AlejandroAriza12/uPMU.AlejandroAriza.LauraSofiaRico/README.md

# uPMU.AlejandroAriza.LauraSofiaRico
Prototipo de micro-sincrofasor (µPMU) de bajo costo para redes de distribución"
