AlejandroAriza12/uPMU.AlejandroAriza.LauraSofiaRico/circuito.jpeg

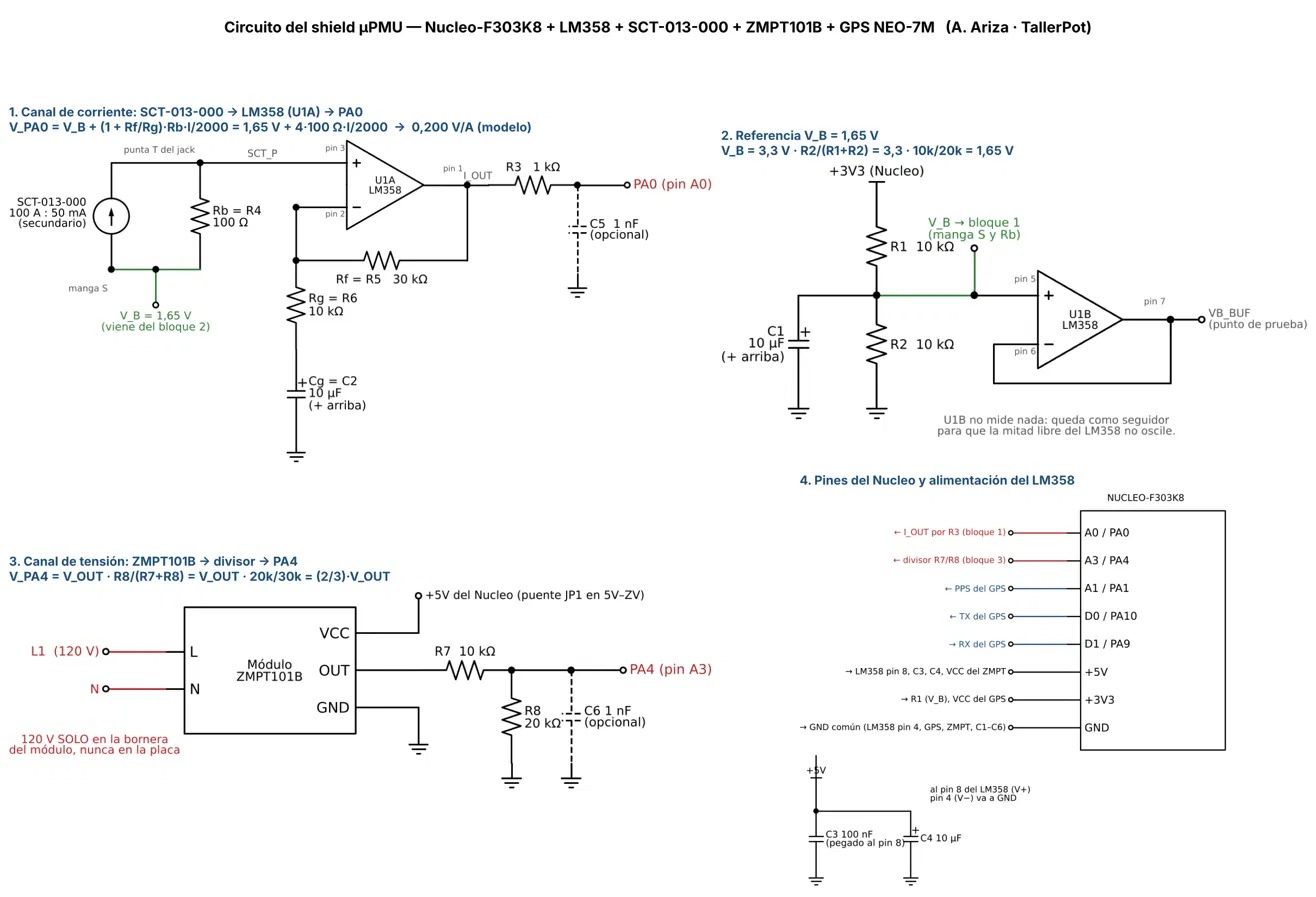
circuito.jpeg
