AlejandroAriza12/uPMU.AlejandroAriza.LauraSofiaRico/Datos_Fasores/real_armonicos.png

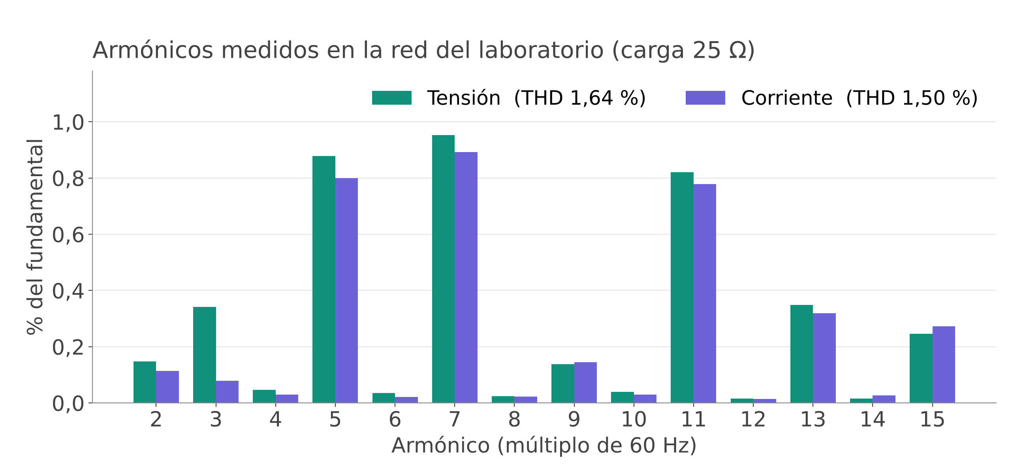
Datos_Fasores/real_armonicos.png
