AlejandroAriza12/uPMU.AlejandroAriza.LauraSofiaRico/Datos_Fasores/real_fasores_tiempo_real.png

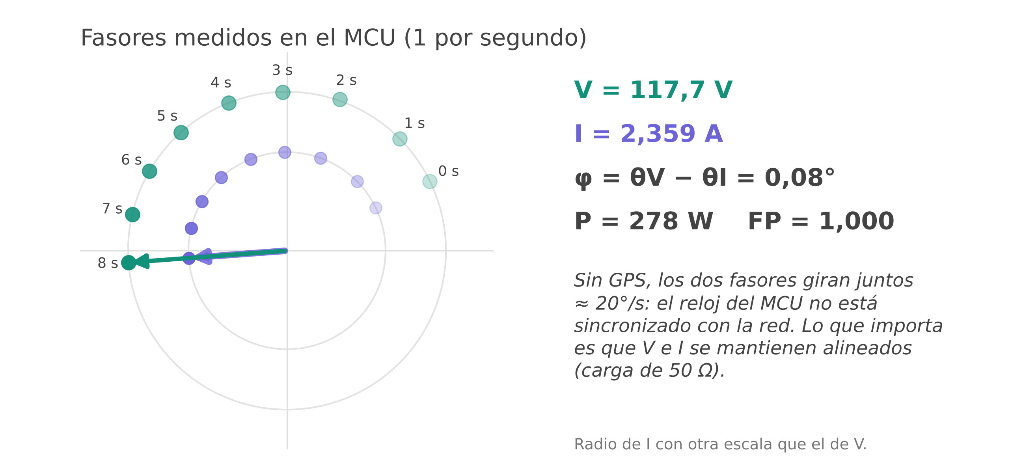
Datos_Fasores/real_fasores_tiempo_real.png
