AlejandroAriza12/uPMU.AlejandroAriza.LauraSofiaRico/Datos_Fasores/real_ondas_fasores.png

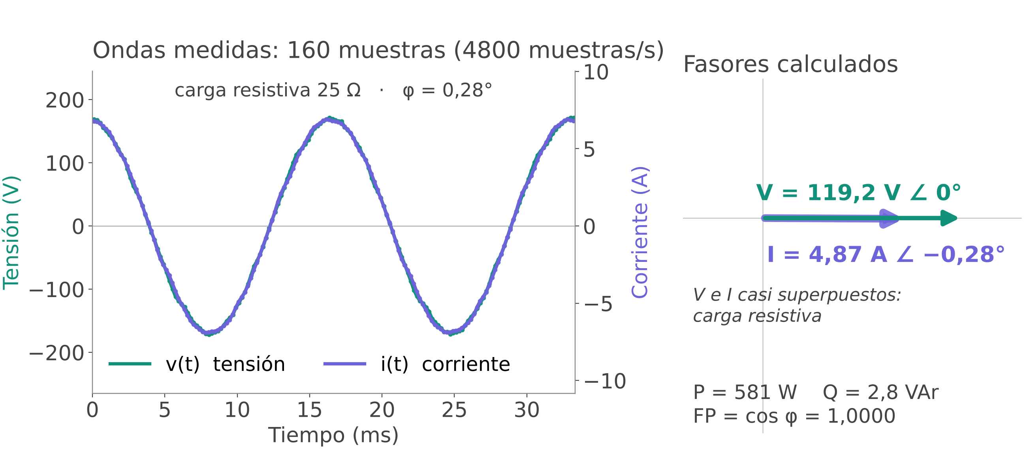
Datos_Fasores/real_ondas_fasores.png
