AlejandroAriza12/uPMU.AlejandroAriza.LauraSofiaRico/PCB/upmu_shield-imagen_placa.png

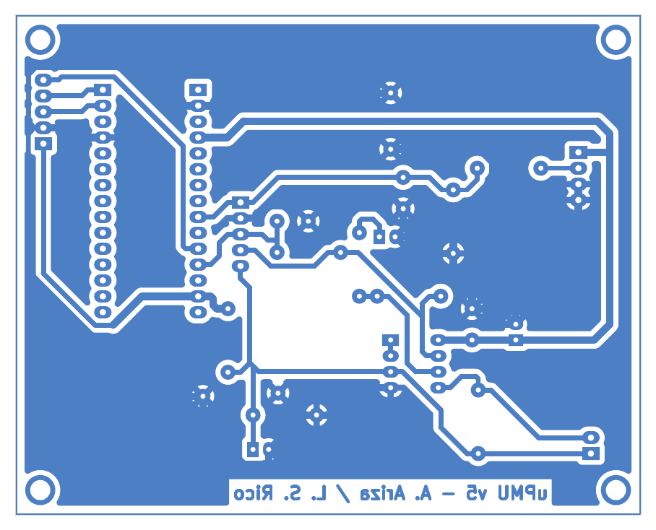
PCB/upmu_shield-imagen_placa.png
