AlejandroAriza12/uPMU.AlejandroAriza.LauraSofiaRico/Resultados_Error/bloques_analizados.csv

archivo | prueba | rol | modo | bloque | pps | seg | t_pc | fs_real | fs_origen | ppm | ref_V | ref_I | ref_ang | ref_f | mediaV | mediaI | satV | satI | Vpin | Ipin | angV | angI | f | f_ok | Vpin_aj | Ipin_aj | angV_aj | angI_aj | f_aj | resV_mV | resI_mV | thdV | thdI | lsb | V | I | angV_c | angI_c | angVI | P | Q | FP
2026-11-10_170417_r50_f.csv | r50 | calibracion | f | 0 | 0 | 0.0 | 1794348242.507 | 4800.0 | nominal (sin corregir) |  | 119.9 | 2.4 | 0.0 |  | 1956.409375 | 1894.69921875 | False | False | 0.27547204760598154 | 0.0001654240617624935 | -70.11402567466448 | -23.126642217747836 | 60.0343424392964 | True | 0.2755224057244155 | 0.00016549433904650433 | -70.09332687527079 | -23.10915620851965 | 60.03365634957356 | 5.127476702074537 | 1.1549581418792467 | 1.7539884433201036 |  | 0.0008058608058608059 | 119.93789970579621 | 0.000852417385092883 | -94.1955898330995 | -24.26664221774783 | -69.92894761535167 | 0.035086276141673756 | -0.09602805964166893 | 0.34318519103028344
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
