AlejandroAriza12/uPMU.AlejandroAriza.LauraSofiaRico/Resultados_Error/calibracion.csv

n_bloques | K_V | K_V_sd | n_V | K_I | K_I_sd | n_I | desfase_VI | desfase_VI_sd | n_ang | CAL_ANG_I | CAL_ANG_V | fase_origen
20 | 0.002296788990650208 | 2.1030589373012268e-06 | 20 | 0.1940646268546813 | 0.00026207088990200944 | 18 | 22.941564158435032 | 0.0707507361261869 | 18 | 1.14 | 24.081564158435032 | supuesta (red Rg-Cg)
