AlejandroAriza12/uPMU.AlejandroAriza.LauraSofiaRico/Resultados_Error/01_forma_de_onda_y_fasores.png

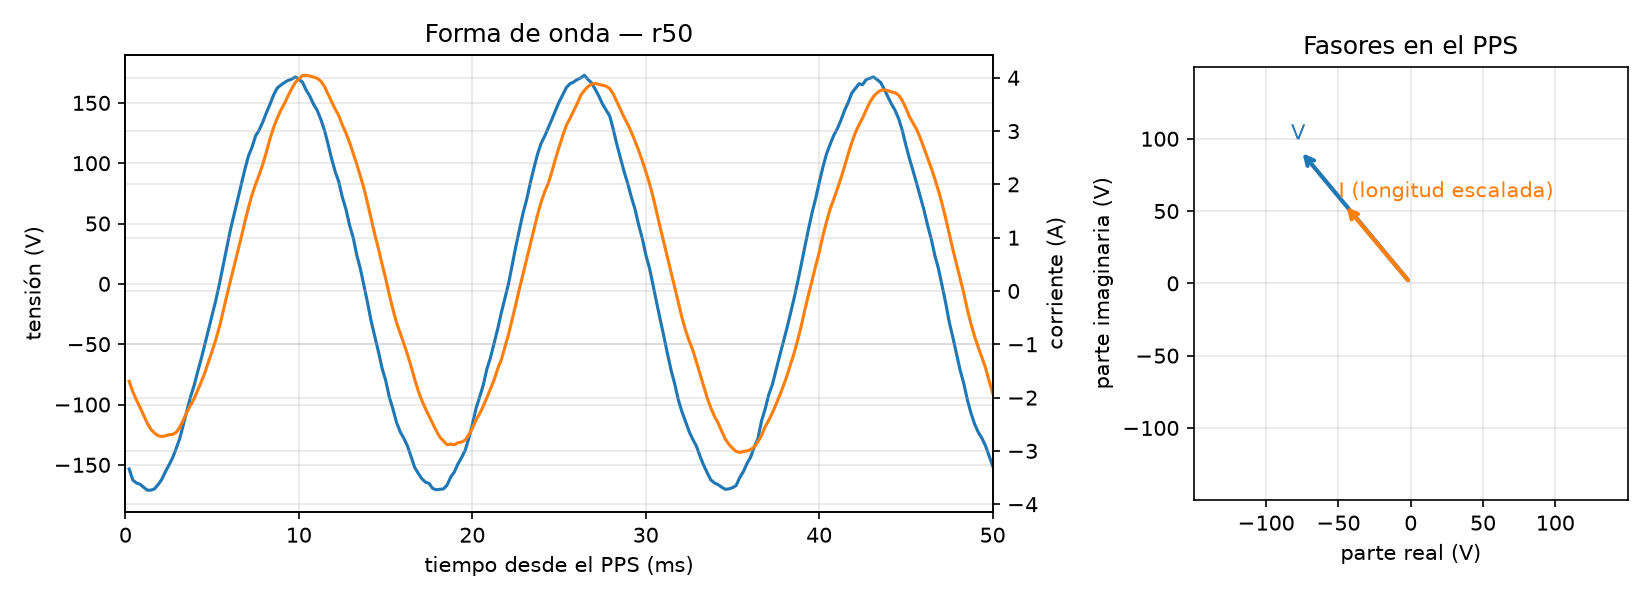
Resultados_Error/01_forma_de_onda_y_fasores.png
