AlejandroAriza12/uPMU.AlejandroAriza.LauraSofiaRico/Resultados_Error/02_exactitud_TVE.png

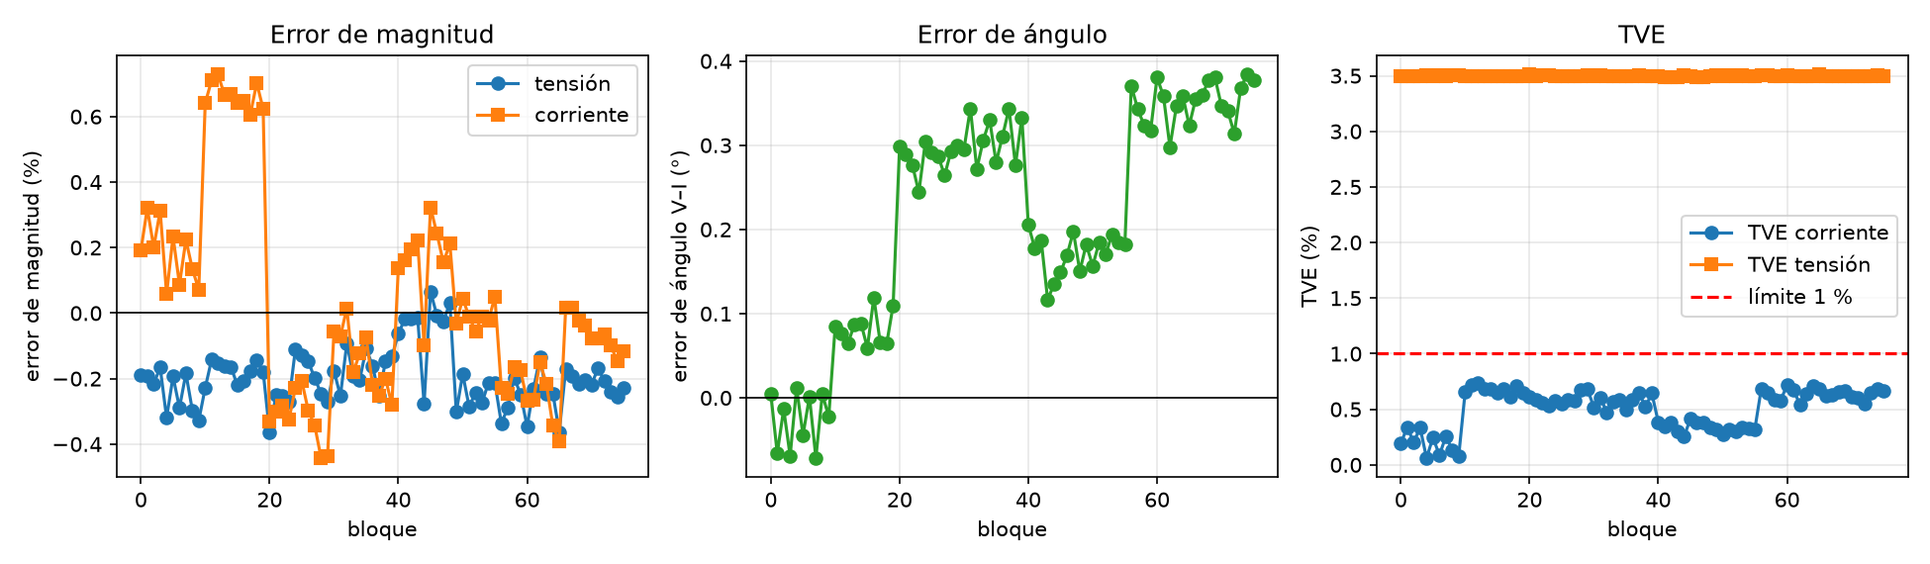
Resultados_Error/02_exactitud_TVE.png
