AlejandroAriza12/uPMU.AlejandroAriza.LauraSofiaRico/Resultados_Error/03_frecuencia_rocof.png

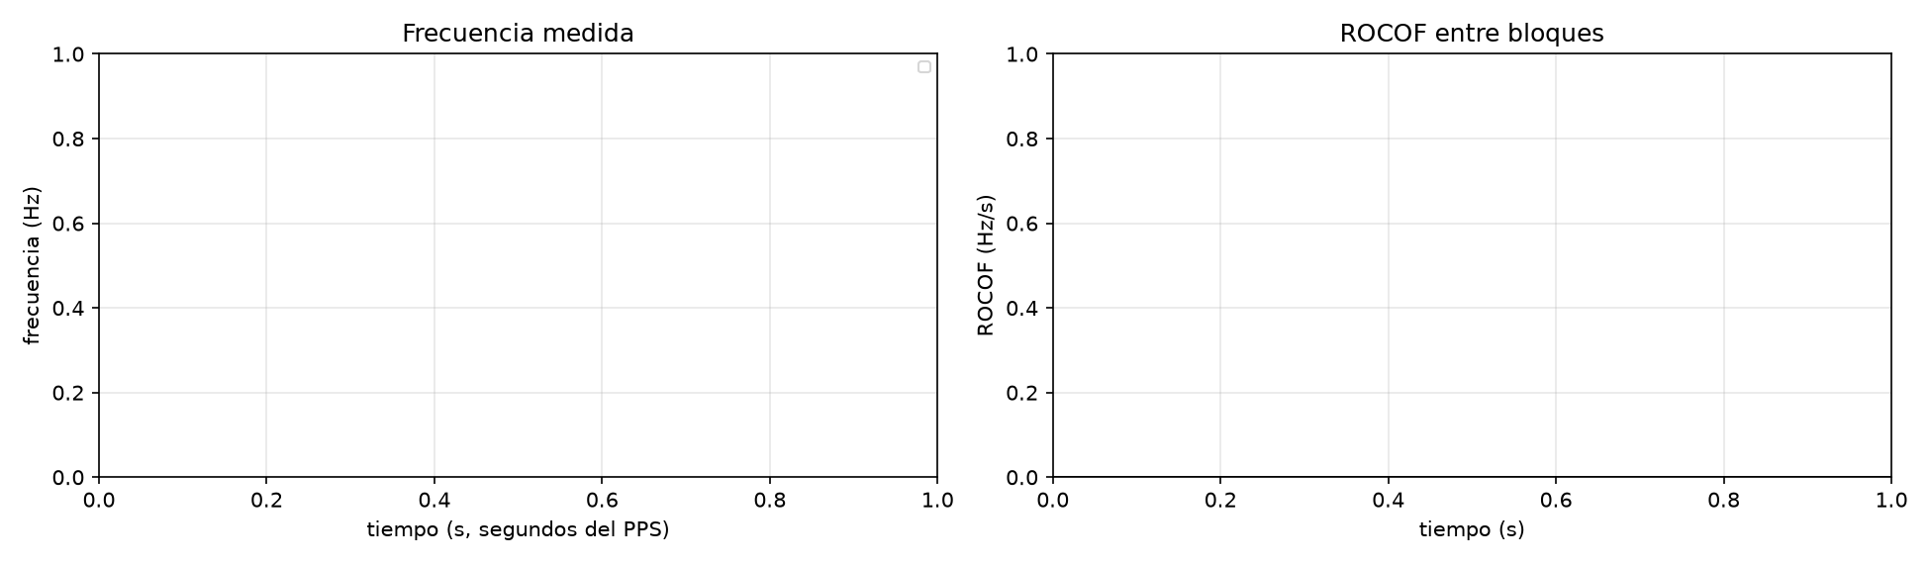
Resultados_Error/03_frecuencia_rocof.png
