AlejandroAriza12/uPMU.AlejandroAriza.LauraSofiaRico/Resultados_Error/04_sincronia.png

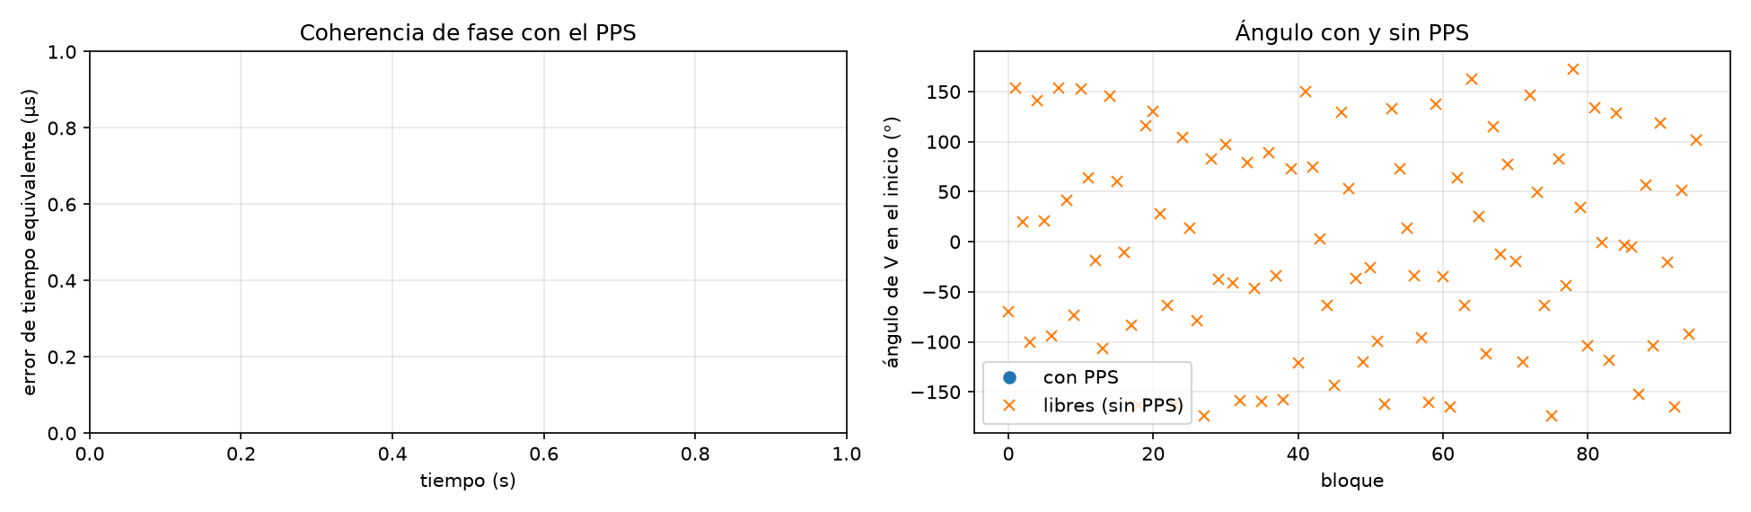
Resultados_Error/04_sincronia.png
