AlejandroAriza12/uPMU.AlejandroAriza.LauraSofiaRico/Resultados_Error/06_algoritmo_tve_vs_frecuencia.png

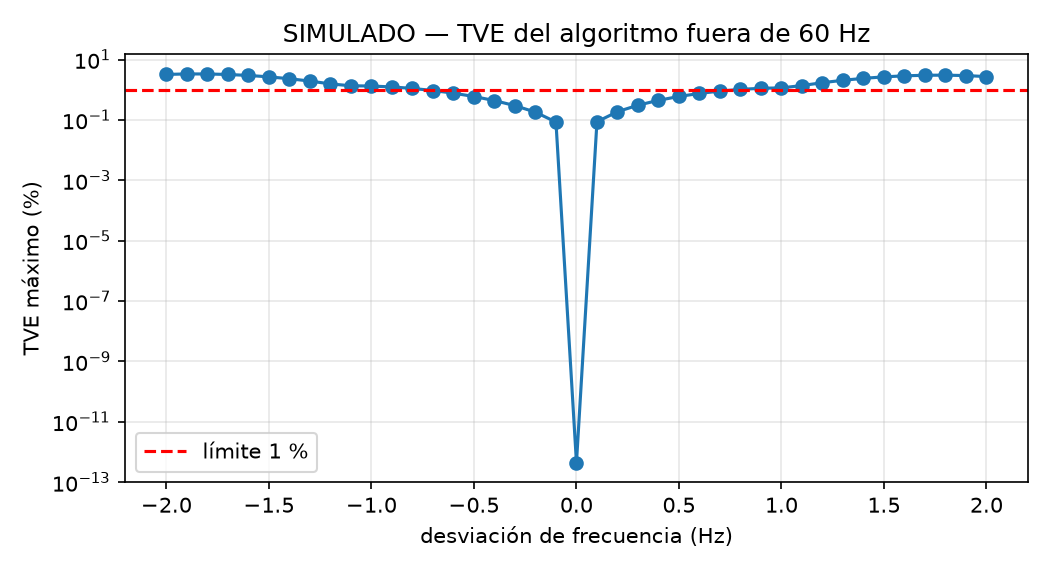
Resultados_Error/06_algoritmo_tve_vs_frecuencia.png
